happyBlairWang/Hardware-VoiceAgent-Night/(list of files, cad)

Other CAD files:
docs/wiring.blend
