happyBlairWang/Hardware-VoiceAgent-Night/docs/wiring_3d.png

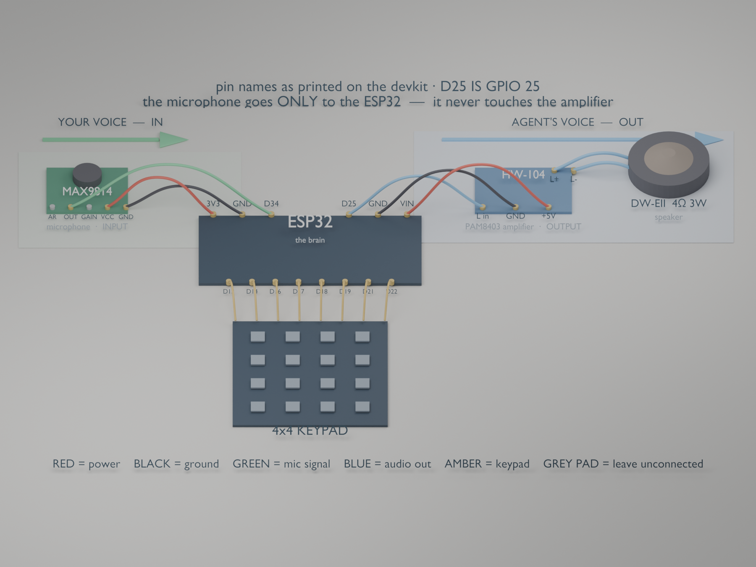
docs/wiring_3d.png
