happyBlairWang/Hardware-VoiceAgent-Night/(commit log)

2026-09-09 Vintage rotary phone as an AssemblyAI voice agent
    A 1955 telephone that answers as a voice agent. Speech goes in through a
    MAX9814 on the handset mic, out through an HW-104 amplifier to the earpiece.
    The ESP32 holds no credential and speaks no TLS: a Python relay on the Mac
    owns the API key, the TLS session and the JSON framing, while the device
    moves raw audio over a plain WebSocket. With 320 KB of RAM and no PSRAM
    there is not room for the WiFi stack, a TLS session and audio buffers at
    once, so the split is a constraint rather than a preference.
    Includes a monitoring dashboard (live meters, hardware self-tests, call
    history), agent tool calling for voice-controlled volume, a kids-safe ag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
    [wiring.blend]
2026-09-12 Add I2S amp path, echo gate on device, and a live monitor UI
    Speaker output can now run either through the built-in 8-bit DAC or an
    external I2S amplifier, chosen by USE_I2S_AMP. The DAC path exists only
    because the built-in ADC and DAC both require I2S0 and the microphone
    already owns it; an external I2S amp has no such constraint and runs on
    I2S1 with DMA doing the timing. The device announces its format on
    connect ("fmt:pcm16@24000" or "fmt:u8@8000") so the relay adapts rather
    than relying on a constant kept in two places.
    Echo suppression moved from the relay onto the device. The relay only
    knows when it queued audio; the ESP32 knows when the DAC is still
    draining it, which is later by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
    [wiring.blend]
2026-09-13 Port to XIAO ESP32-S3, add camera, and run the agent without a phone
    The XIAO replaces the MAX9814 and the analog audio path entirely. Its PDM
    microphone has no bias voltage to collapse and no AGC to clip, which were the
    two failure modes that kept wedging the old mic. Audio out goes to the NS4168
    over I2S: on the S3 the built-in DAC does not exist, and an external I2S amp
    runs on I2S1 rather than fighting the microphone for I2S0.
    Three bugs this shook out, all the same shape -- code that assumed the ESP32
    was the only audio path:
    * the speaker was silent because playback sent one I2S channel while the
    NS4168's floating CTRL pin chose the other. It now sends both.
    * camera frames k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
    [xiao_cam_test.cpp, xiao_main.cpp, xiao_spk_test.cpp]
2026-09-29 Run a speaker-labelled notetaker alongside the voice agent
    Microphone audio now fans out to two AssemblyAI streams at once: the
    Voice Agent for conversation, and the Streaming API for notes. The
    agent's recognition is tuned for speed; the notetaker runs
    universal-3-5-pro in max_accuracy mode with speaker labels, so it is
    the more reliable record. In testing it transcribed a sentence
    word-perfect that the agent answered with "I didn't catch that".
    Pip's own lines join the notes from the agent's clean transcript rather
    than being re-transcribed off the speaker, so nobody appears twice.
    A mode switch adds a listen-only notetaker. The dashboard switches
    immediately and discards any reply in fl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
2026-09-29 Remove unused code and fix the broken phone build
    The phone firmware had not compiled since the XIAO port on 09-12. The
    esp32dev build took every source file except the speaker test ("+<*>
    -<speaker_test.cpp>"), so when three XIAO firmware files arrived, it
    swept them in too -- and each defines its own setup() and loop(),
    giving "multiple definition" link errors. It now names main.cpp. All
    four targets build again: esp32dev, xiao, xiaospk, xiaocam.
    Removed:
    - seeed/, a separate notetaker project nothing referenced. Its three
    recordings were never in git, so they were copied out and verified
    byte-for-byte before deletion rather than lost.
    - src/speaker_test.cpp and its build target. It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
2026-09-29 Chat with your notes through AssemblyAI LLM Gateway
    A Chat tab answers questions about the notes, Granola-style, using any
    of the models LLM Gateway offers. Answers come only from the notes,
    cite when each thing was said, and say so when the notes don't cover
    the question. Follow-up questions carry the conversation so far.
    Checked against the live API on 2026-09-29:
    - GET /v1/models lists what is actually available (47 models). The
    quickstart's example, qwen3.5-4b-fast, is not among them and returns
    400 "not supported" -- so the picker is filled from the live list and
    never offers a model that would fail.
    - The raw key and "Bearer <key>" both authenticate, unlike the two
    audio APIs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
2026-10-07 Rename to Furby, add persistent memory and web search
    Every session now starts with relay/memory.md in its prompt, plus today's
    date, so the agent knows durable facts across calls. A "remember" tool
    appends to it by voice. Two things were needed before it worked:
    * an identity line. A fact stored as "Harnoor's mother's birthday" did
    not match "my mom's birthday" until the prompt said who is speaking.
    * an instruction to disagree. Without it the agent deferred to whatever
    it was told, which is backwards for a memory feature. It now corrects
    a wrong date instead of agreeing with it.
    memory.md is gitignored because it holds real personal facts and changes at
    runtime; memory.ex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
2026-10-07 Feed the notetaker silence while the echo gate is shut
    The echo gate stops Furby's own voice reaching the notetaker by dropping
    mic frames while it speaks. Dropping them starved the streaming notetaker,
    which closes a turn by hearing silence after it. If Furby started replying
    before that silence arrived (the notetaker can wait up to 2 s in accuracy
    mode), the previous sentence stayed open and was never written down. In
    testing, "the dentist appointment moved to Thursday" reached the agent, and
    Furby answered it, but it never appeared in the notes.
    Gated frames now reach the notetaker as zeros of the same length. It still
    never hears Furby, but it still hears time passing. This applies to b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
2026-10-07 Finish the Furby rename in the workshop guides
    The guides still said "Pip" and "Hey Pip" in 16 places, so workshop
    attendees would have been told to say a wake word that no longer works.
    Two passages were also out of date, not just misnamed:
    * Phase 3's fan-out said echo-gated frames "never reach" the notetaker,
    and its snippet dropped them. That is the pattern behind the
    dropped-sentence bug fixed in 714ebca: anyone following the guide would
    rebuild it. The snippet now passes silence to the notetaker and explains
    why.
    * The wake-word pitfall described the old rule ("Pip is hard to hear"). It
    now explains why an address is required, and how the comma tells "Furby,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
2026-10-07 Move the build-voice-agent skill to the repo root
    SKILL.md and references/ now sit at the top level, where they are the first
    thing seen on GitHub and the repo can be installed as a skill directly.
    They are mirrored into .claude/skills/build-voice-agent/ because Claude Code
    only loads project skills from there automatically, and that is what gives
    anyone who clones the repo the skill without setup.
    tests/verify.py now fails if the mirror differs from the root copy, and
    prints the cp command that fixes it. It also checks that relay/memory.md
    stays untracked.
    README links to the skill.
2026-10-08 Add the Luna profile and make the relay run on a fresh Mac
    Luna is a compassionate, non-judgemental listener for adults: reflects the
    feeling first, asks one open question at a time, gives advice only when
    asked, and stays with anyone who speaks of being in danger. Voice "jane".
    The wake word, dashboard copy, memory template and verify script follow the
    new name; the regex also accepts "lunar"/"loona", which is what streaming STT
    tends to hear.
    Two fixes needed to run this at all on a new machine:
    - python.org builds of Python ship no root certificates, so every wss://
    connect failed with CERTIFICATE_VERIFY_FAILED. ./phone now points OpenSSL
    at certifi's bundle from the venv.
    - The def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
